ervanalb/hanging-garden/kelp-pcb/kelp-pcb.kicad_pcb

## KiCad design kelp-pcb/kelp-pcb.kicad_pcb (2026-07-27)

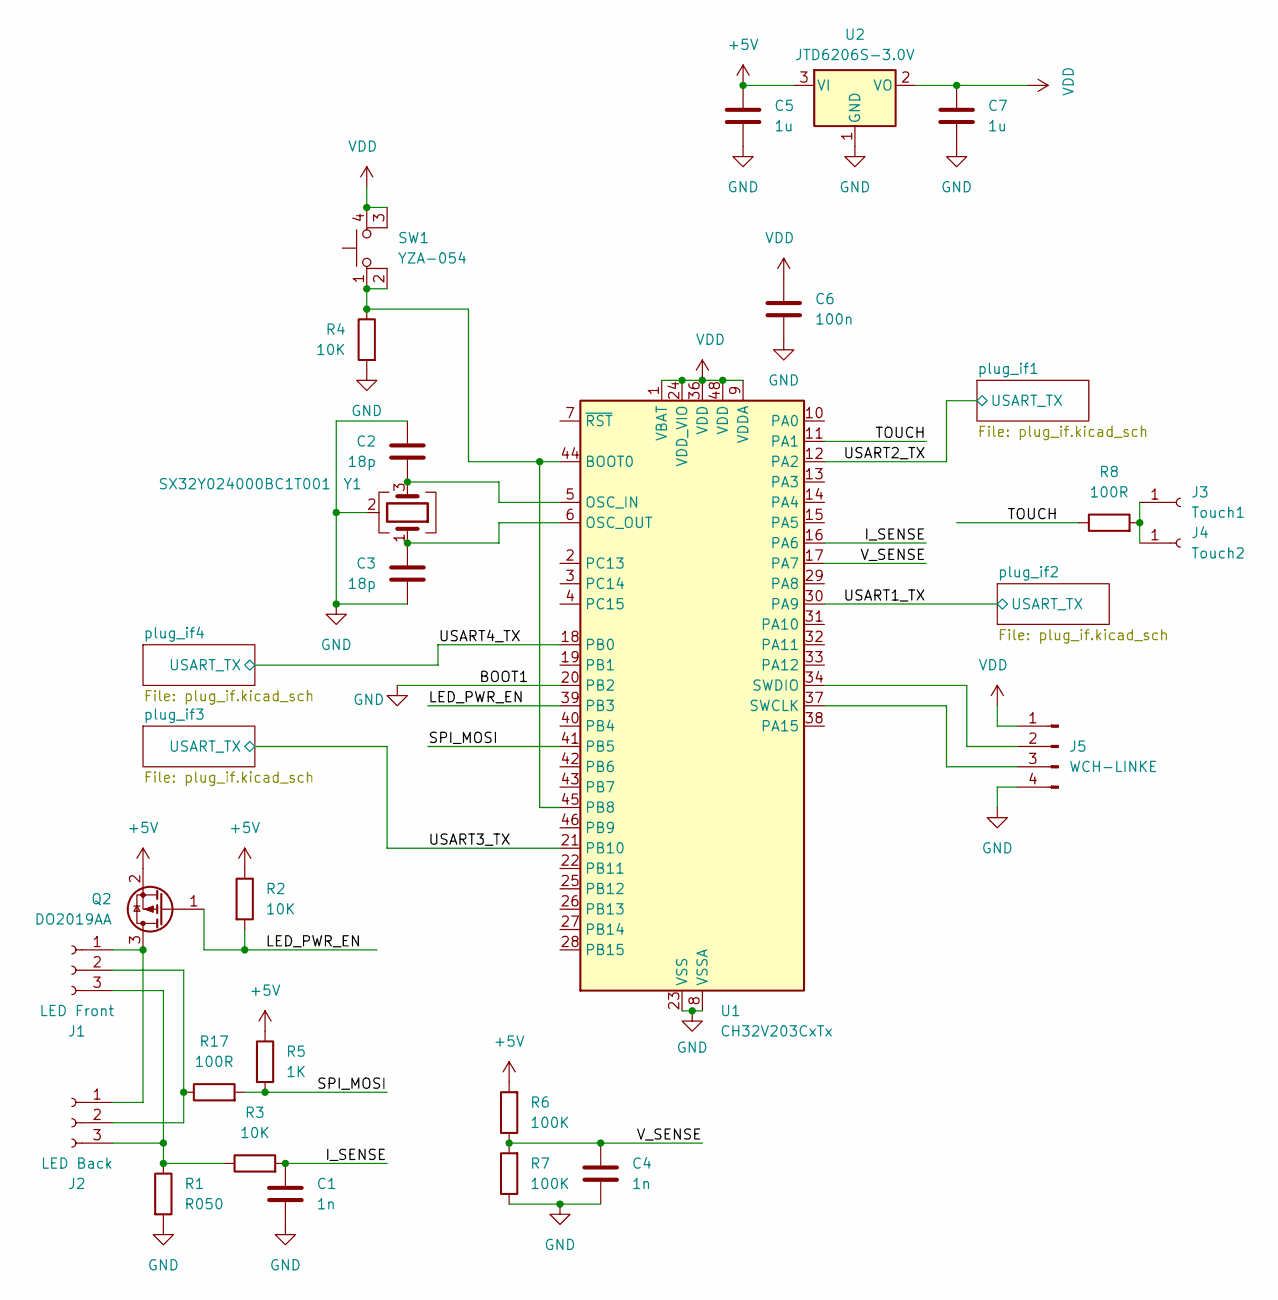
[picture p1: schematic kelp-pcb.kicad_sch]

Parts:
C1, C4: 1n; C_0402_1005Metric
C2, C3: 18p; C_0402_1005Metric
C5, C7: 1u; C_0603_1608Metric
C6: 100n; C_0402_1005Metric
J1: LED Front; led_strip
J2: LED Back; led_strip
J3: Touch1; sew_pad
J4: Touch2; sew_pad
J5: WCH-LINKE; PinHeader_1x04_P2.54mm_Vertical
Q2: DO2019AA; SOT-23
R1: R050; R_1206_3216Metric
R2, R3, R4: 10K; R_0402_1005Metric
R5: 1K; R_0402_1005Metric
R6, R7: 100K; R_0402_1005Metric
R8, R17: 100R; R_0402_1005Metric
SW1: YZA-054
U1: CH32V203CxTx; QFN-48-1EP_7x7mm_P0.5mm_EP5.3x5.3mm
U2: JTD6206S-3.0V; SOT-23-3
Y1: SX32Y024000BC1T001; Crystal_SMD_3225-4Pin_3.2x2.5mm

Connections:
+5V: C5.1, Q2.2 (S), R2.1, R5.1, R6.2, U2.3 (VI); also elsewhere on the board
/I_SENSE: C1.1, R3.2, U1.16 (PA6)
/LED_PWR_EN: Q2.1 (G), R2.2, U1.39 (PB3)
/SPI_MOSI: R5.2, R17.2, U1.41 (PB5)
/TOUCH: R8.1, U1.11 (PA1)
/USART1_TX: U1.30 (PA9); also elsewhere on the board
/USART2_TX: U1.12 (PA2); also elsewhere on the board
/USART3_TX: U1.21 (PB10); also elsewhere on the board
/USART4_TX: U1.18 (PB0); also elsewhere on the board
/V_SENSE: C4.1, R6.1, R7.2, U1.17 (PA7)
GND: C1.2, C2.1, C3.2, C4.2, C5.2, C6.2, C7.2, J5.4, R1.2, R4.2, R7.1, U1.8 (VSSA), U1.20 (PB2), U1.23 (VSS), U1.35 (VSS), U1.47 (VSS), U2.1 (GND), Y1.2 (G), Y1.4 (G); also elsewhere on the board
unnamed: J1.1, J2.1, Q2.3 (D)
unnamed: J1.2, J2.2, R17.1
unnamed: J1.3, J2.3, R1.1, R3.1
unnamed: J3.1 (Pin_1_1), J4.1 (Pin_1_1), R8.2
unnamed: J5.2, U1.34 (SWDIO)
unnamed: J5.3, U1.37 (SWCLK)
unnamed: R4.1, SW1.1, SW1.2, U1.44 (BOOT0), U1.45 (PB8)
unnamed: C2.2, U1.5 (OSC_IN), Y1.3
unnamed: C3.1, U1.6 (OSC_OUT), Y1.1
VDD: C6.1, C7.1, J5.1, SW1.3 (K), SW1.4 (A), U1.1 (VBAT), U1.9 (VDDA), U1.24 (VDD_VIO), U1.36 (VDD), U1.48 (VDD), U2.2 (VO); also elsewhere on the board

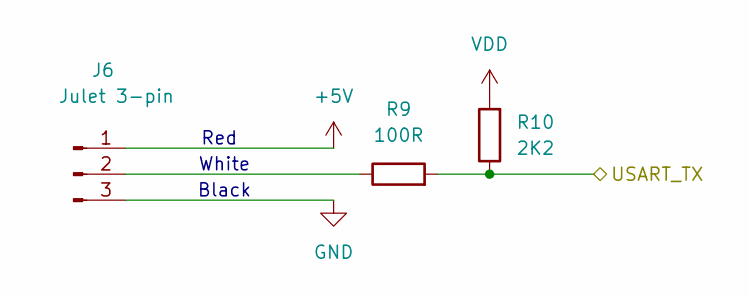
[picture p2: schematic plug_if.kicad_sch]

Parts:
J6: Julet 3-pin; julet_3pin
R9: 100R; R_0402_1005Metric
R10: 2K2; R_0402_1005Metric

Connections:
+5V: J6.1; also elsewhere on the board
/USART2_TX: R9.2, R10.1; also elsewhere on the board
GND: J6.3; also elsewhere on the board
unnamed: J6.2, R9.1
VDD: R10.2; also elsewhere on the board

Parts of its further copies:
J7, J8, J9: Julet 3-pin; julet_3pin
R11, R13, R15: 100R; R_0402_1005Metric
R12, R14, R16: 2K2; R_0402_1005Metric

Connections of its further copies:
+5V: J7.1, J8.1, J9.1; also elsewhere on the board
/USART1_TX: R11.2, R12.1; also elsewhere on the board
/USART3_TX: R13.2, R14.1; also elsewhere on the board
/USART4_TX: R15.2, R16.1; also elsewhere on the board
GND: J7.3, J8.3, J9.3; also elsewhere on the board
unnamed: J7.2, R11.1
unnamed: J8.2, R13.1
unnamed: J9.2, R15.1
VDD: R12.2, R14.2, R16.2; also elsewhere on the board

Notes on the sheet:
White
Black
Red

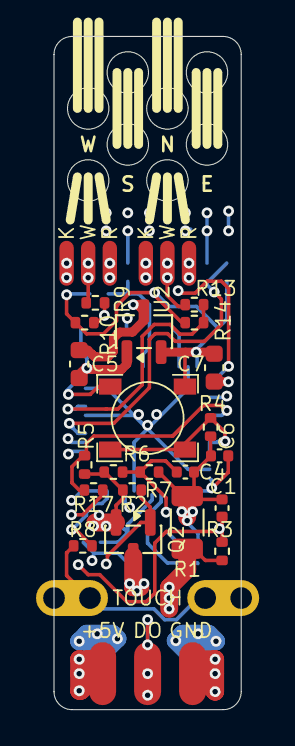
[picture p3: board kelp-pcb.kicad_pcb from above]

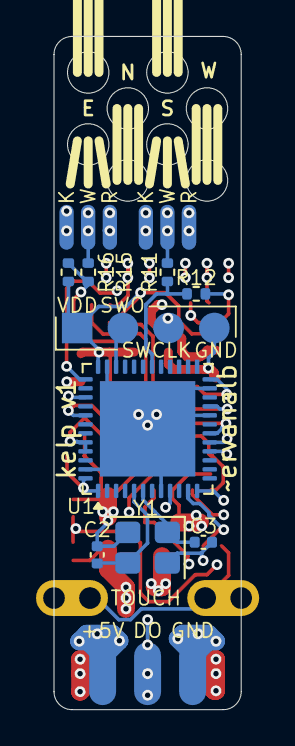
[picture p4: board kelp-pcb.kicad_pcb from below]

Board: 4 copper layers, 10.4 x 37.4 mm, 38 parts (12 on the bottom side), 25 nets.
