ervanalb/hanging-garden/firmware/kelp-app/build.rs

use std::fs;

fn main() {
    // Error if building in debug mode
    //let profile = std::env::var("PROFILE").unwrap();
    //if profile == "debug" {
    //    panic!("bootloader must be built in release mode. Add the --release flag.");
    //}

    // println!("cargo:rustc-link-arg-bins=--nmagic");
    println!("cargo:rustc-link-arg-bins=-Tlink.x");
    // println!("cargo:rustc-link-arg-bins=-Tdefmt.x");

    let out_dir = std::env::var("OUT_DIR").unwrap();
    let out_dir = std::path::PathBuf::from(out_dir);
    println!("cargo:rustc-link-search={}", out_dir.display());

    // Copy unified_memory.x from workspace root
    fs::copy("../hal/unified_memory.x", out_dir.join("unified_memory.x")).unwrap();
    println!("cargo:rerun-if-changed=../hal/unified_memory.x");

    // Copy app-specific linker script
    fs::copy("memory.x", out_dir.join("memory.x")).unwrap();
    println!("cargo:rerun-if-changed=memory.x");
}
