ervanalb/hanging-garden/(commit log)

2026-07-27 Add V1 of kelp PCB
    [hanging-garden-pcb-B_Cu.gbr, hanging-garden-pcb-B_Mask.gbr, hanging-garden-pcb-B_Paste.gbr, hanging-garden-pcb-B_Silkscreen.gbr, hanging-garden-pcb-Edge_Cuts.gbr, hanging-garden-pcb-F_Cu.gbr, hanging-garden-pcb-F_Mask.gbr, hanging-garden-pcb-F_Paste.gbr]
2026-07-27 Rename to kelp-pcb
    [kelp-pcb-B_Cu.gbr, kelp-pcb-B_Mask.gbr, kelp-pcb-B_Paste.gbr, kelp-pcb-B_Silkscreen.gbr, kelp-pcb-Edge_Cuts.gbr, kelp-pcb-F_Cu.gbr, kelp-pcb-F_Mask.gbr, kelp-pcb-F_Paste.gbr]
2026-07-27 Rename to kelp & add firmware folder
    [kelp-pcb-B_Cu.gbr, kelp-pcb-B_Mask.gbr, kelp-pcb-B_Paste.gbr, kelp-pcb-B_Silkscreen.gbr, kelp-pcb-Edge_Cuts.gbr, kelp-pcb-F_Cu.gbr, kelp-pcb-F_Mask.gbr, kelp-pcb-F_Paste.gbr]
2026-08-18 Switch to PAC-only approach
2026-08-18 Get LED interrupt working
2026-08-19 LED strip output working
2026-08-21 Implement embassy time driver
2026-08-24 Remove cargo workspace, switch to individual crates
2026-09-01 Fix some issues, introduce flip-link, and write firmware update capability into gflash
    [lib.rs, main.rs]
2026-09-17 Fix some message ordering, and overrun recovery, and switch to defmt
    [lib.rs, main.rs]
2026-09-17 Fix some bootloader issues and add progress bar
    [build.rs, main.rs]
2026-09-26 Fix off-by-one errors in chunk accounting
    [main.rs]
2026-09-28 Adjust buffer sizes, add flip-link to BL, seed RNG with chip ID, and fix some BL Init msg logic
    [lib.rs, main.rs]
